peterbalch/Quadruped2/Instructables source/IMG_0923.JPG

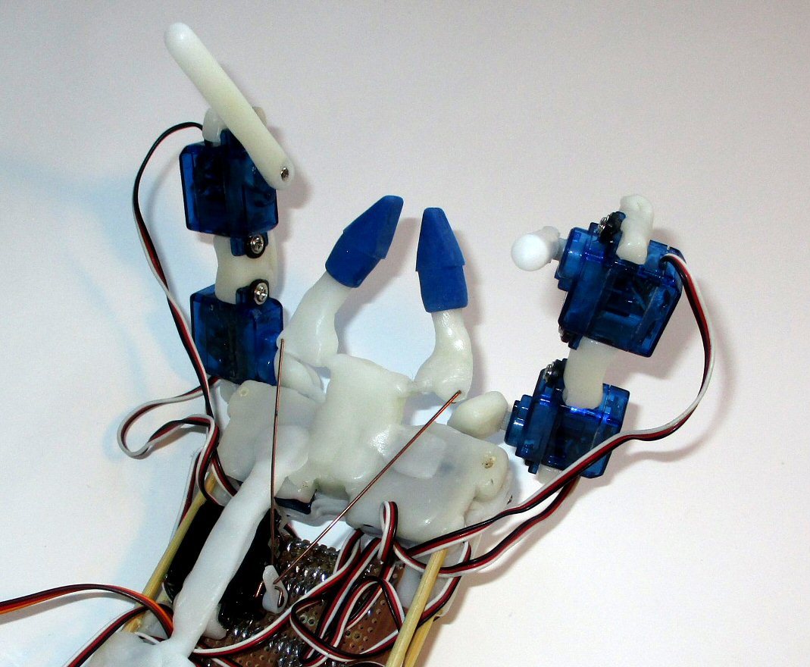
Instructables source/IMG_0923.JPG
