peterbalch/Quadruped2/Instructables source/quadruped.jpg

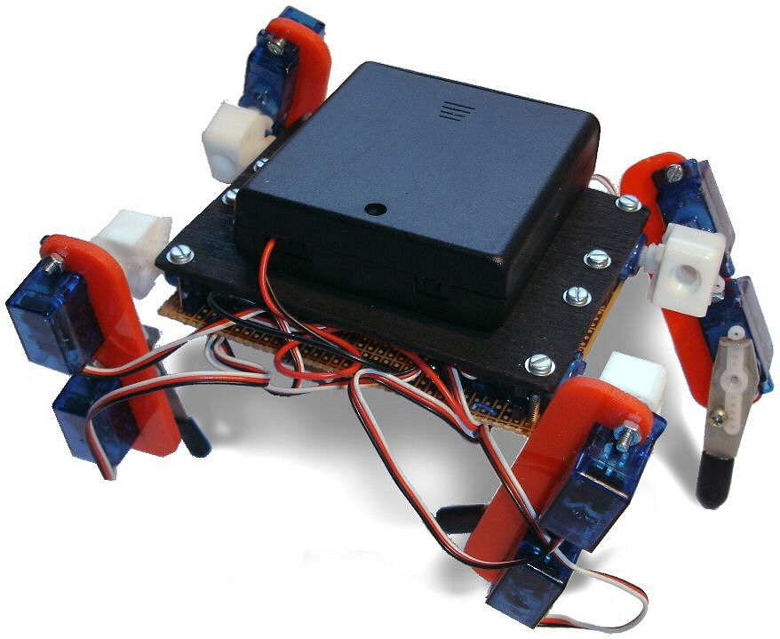
Instructables source/quadruped.jpg
