peterbalch/Quadruped2/Prog/Servo18.rtf

The Arduino Quad3.ino sketch can control up to 18 servos.
• Servo 0 = pin D2
• Servo 1 = pin D3
• Servo 2 = pin D4
• Servo 3 = pin D5
• Servo 4 = pin D6
• Servo 5 = pin D7
• Servo 6 = pin D8
• Servo 7 = pin D9
• Servo 8 = pin D10
• Servo 9 = pin A0
• Servo 10 = pin A1
• Servo 11 = pin A2
• Servo 12 = pin A3
• Servo 13 = pin A4
• Servo 14 = pin A5
• Servo 15 = pin D11
• Servo 16 = pin D12
• Servo 17 = pin D13

The sketch includes my own version of the Servos.h Arduino library but I have added more servos. The standard library allows a maximum of 12 servos per timer and for the Arduino Nano, it uses only one timer. I've modified the Servos.h file to allow 18 servos per timer.

#define SERVOS_PER_TIMER 18 // the maximum number of servos controlled by one timer

And I've renamed it to myServos. Put all the files in the same directory as the Quad3.ino sketch.

Using 18 sevos per timer alters the timing a little when you're using all the servo pins at once but seems to work OK.

Gait-tables can be stored in PROGMEM or EEPROM.

To use EEPROM, include this line in the sketch
• #define UseEEPROM
(It's commented out by default.)

I don't recommend using EEPROM. It's too small to be useful. If a gait typically has 12 poses for 12 servos, that's 144 bytes, So you'll only have room for 7 gaits in the 1024 bytes of EEPROM.

I'm going to assume you're using PROGMEM which is much bigger. In theory you'll have room for hundreds of gait.

Each gait-table has the following format:

• number of poses in gait (1 byte)
• ServoSet - 1 bit per servo (4 bytes)
• servo angles (numposes * servoset.count bytes)

The last gait is followed by a zero byte to mark the end of the tables
• 0 (1 byte)

The Servo18.exe program can write its gait-tables to a file usually called Gaits.h.

A typical Gaits.h file contains
• const byte WaveLegs[] PROGMEM = {
• 9, // num poses
• 0xFB,0x1F,0x00,0x00, // servo set
• 71, 149, 90, 90, 90, 90, 36, 109, 86, 134, 75, 54,
• 71, 149, 90, 90, 90, 90, 36, 109, 86, 134, 134, 120,
• 71, 149, 90, 90, 90, 90, 36, 109, 86, 134, 75, 54,
• 71, 149, 90, 90, 90, 90, 36, 109, 136, 53, 75, 54,
• 71, 149, 90, 90, 90, 90, 36, 109, 86, 134, 75, 54,
• 133, 88, 90, 90, 90, 90, 36, 109, 86, 134, 75, 54,
• 71, 149, 90, 90, 90, 90, 36, 109, 86, 134, 75, 54,
• 71, 149, 90, 90, 90, 90, 84, 41, 86, 134, 75, 54,
• 71, 149, 90, 90, 90, 90, 36, 109, 86, 134, 75, 54};
•
• const byte Grip[] PROGMEM = {
• 2, // num poses
• 0x04,0x00,0x00,0x00, // servo set
• 79,
• 136};

This example contains two gaits: WaveLegs and Grip. With WaveLegs, the robot lies on its back waving its legs in the air (a useful test!). With Grip, the robot opens and closes its gripper.

The WaveLegs table says that is contains 9 poses. The servos it uses are in the set 0x1FFB. That's a long integer with 1 bit per servo There are 12 bits set so the gait uses 12 servos. Bit 2 is set to zero so servo 2 is not used. Then come 9 poses and each pose specifies the angles of 12 servos.

The Grip table says that it contains 2 poses - gripper open or closed. The servos it uses are in the set 0x0004. There is one bit set in the servo-set so the gait uses 1 servo. Bit 2 is set so servo 2 is used for the gripper.

Of course, you will have plugged the leg and gripper servos into different pins. You will have specifed that in the Servo18.exe program.

Opening and closing the gripper is not really a "gait" but it's controlled by a gait-table so we'll call it a gait.

The Arduino Quad3.ino sketch can accept the following command bytes over the USB cable from the PC:

• 181..199: select the current servo as N-181
• 0..180: select the current servo angle to N
• 200: send EEPROM contents from PC to Arduino
• followed by 1024 bytes of data
• Arduino replies to each byte with 0xFF
• 201: fetch EEPROM contents from Arduino to PC
• Arduino replies with 1024 bytes of data followed by 0xFF
• 202: starts running a gait in the Arduino
• followed by 1 byte of gait number
• Arduino replies with 0xFF
• 203: set MaxSpeed
• followed by 1 byte of gait number
• followed by 1 byte of speed
• Arduino replies with 0xFF
• 204: set MinTime
• followed by 1 byte of gait number
• followed by 1 byte of min approach time
• Arduino replies with 0xFF
• 205: BlendRun:
• followed by 1 byte of gait table A
• followed by 1 byte of share of A
• followed by 1 byte of gait table B
• followed by 1 byte of share of B
• followed by 1 byte of start pose; may be 255
• followed by 1 byte of end pose; may be 255
• Arduino replies with 0xFF
• 206: StopNow:
• followed by 1 byte of gait number
• Arduino replies with 0xFF
• 207: StopWhen:
• followed by 1 byte of gait number
• followed by 1 byte of pose number
• Arduino replies with 0xFF
• 208: QueryPose
• followed by 1 byte of gait number
• Arduino replies with the current pose of the gait (or 255 if gait not running)
• 209: AtTargets
• followed by 1 byte of gait number
• Arduino replies with 1 if serovs positions same as target positions; 0 they are not or 255 if gait not running

Commands 200 and 201 can only be used if you've enabled storing gaits in EEPROM.

You can run a gait from your program by calling
• RunTable(WaveLegs, 0, 255);

start running a gait <<<<<<<<<<<<<<
void RunTable(int gait_table_addr, byte poseN, byte poseM)
run once from pose N to pose M
if N = 255 then start wherever you currently are
if M = 255 then run forever
loop back to beginning

each gait has its own max speed
each gait has its own min time

The function of the Quad3.ino sketch is to accept and run commands from a PC and allow you to develop your gait-tables. You will replace it with your own sketch that does something useful with your robot.

Notice how the main loop of my program contains the code

RunGaits();

RunGaits() runs the code to control running the gait tables. If you don't call it every few milliseconds, none of the gaits will run. So you must remember to call it inside any loops that are waiting for something to happen.
