peterbalch/Quadruped2/Prog/ARDUINO.BMP

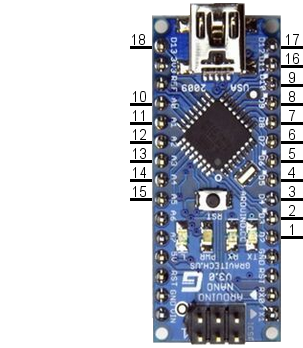
Prog/ARDUINO.BMP
