peterbalch/Quadruped2/Prog/Arm.bmp

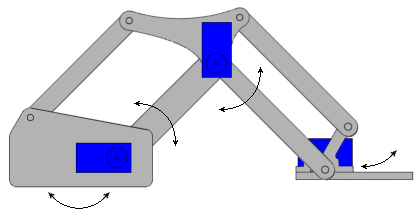
Prog/Arm.bmp
