peterbalch/Quadruped2/Prog/WALK2.BMP

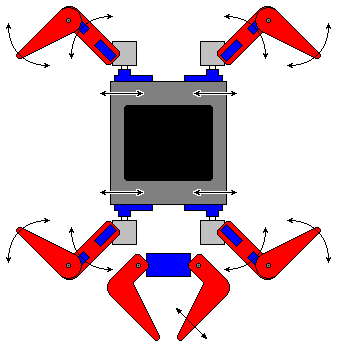
Prog/WALK2.BMP
