peterbalch/Quadruped2/Instructables source/grip.png

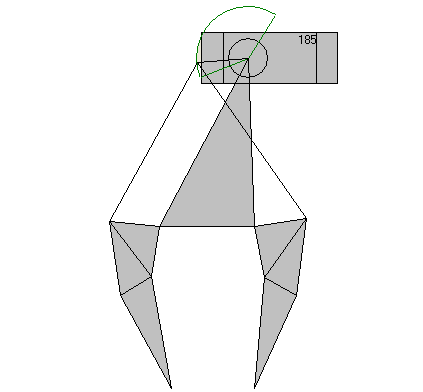
Instructables source/grip.png
