peterbalch/Quadruped2/Instructables source/Image2.jpg

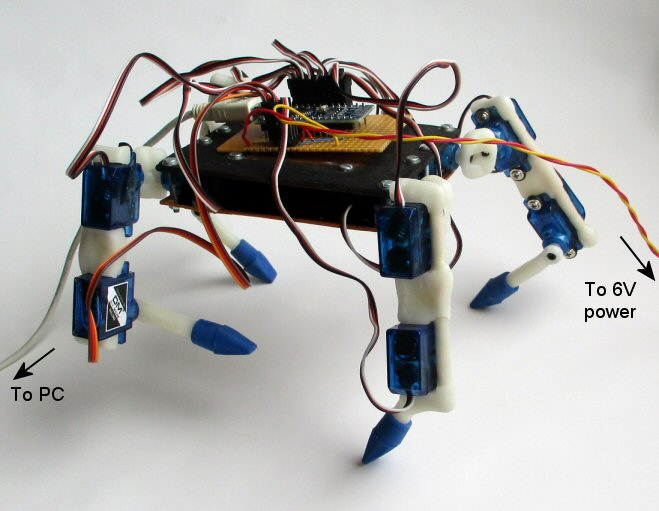
Instructables source/Image2.jpg
