peterbalch/Quadruped2/Instructables source/Image2a.png

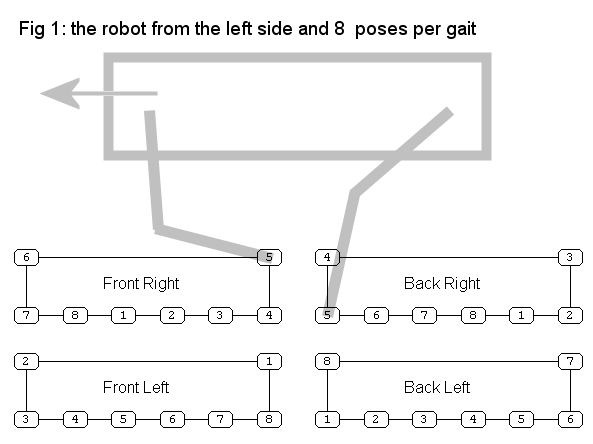
Instructables source/Image2a.png
