peterbalch/Quadruped2/Instructables source/Image2b.png

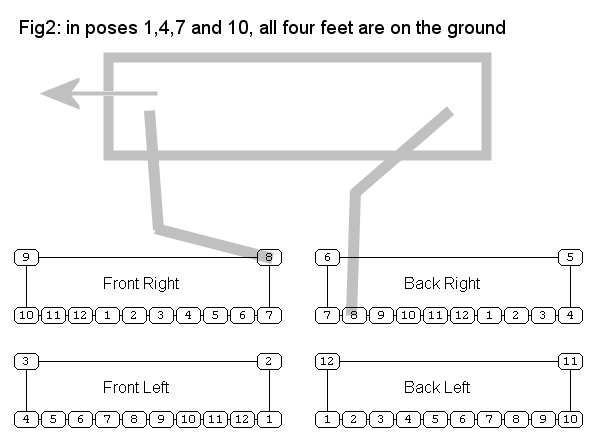
Instructables source/Image2b.png
