peterbalch/Quadruped2/Instructables source/Image3.png

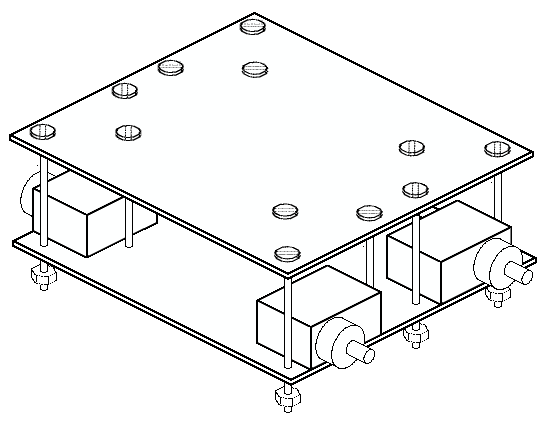
Instructables source/Image3.png
