peterbalch/Quadruped2/Instructables source/Image4.png

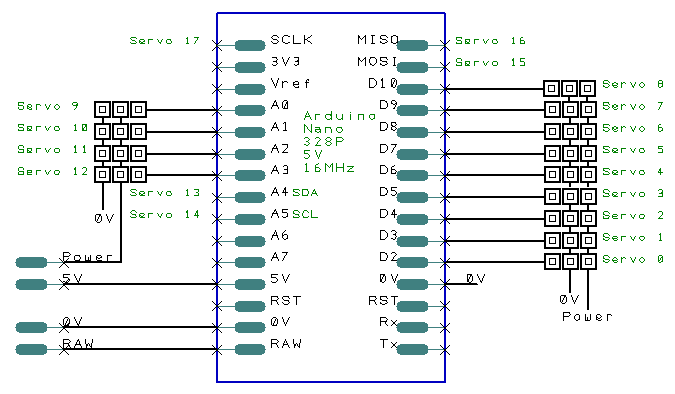
Instructables source/Image4.png
