peterbalch/Quadruped2/Instructables source/Image5.png

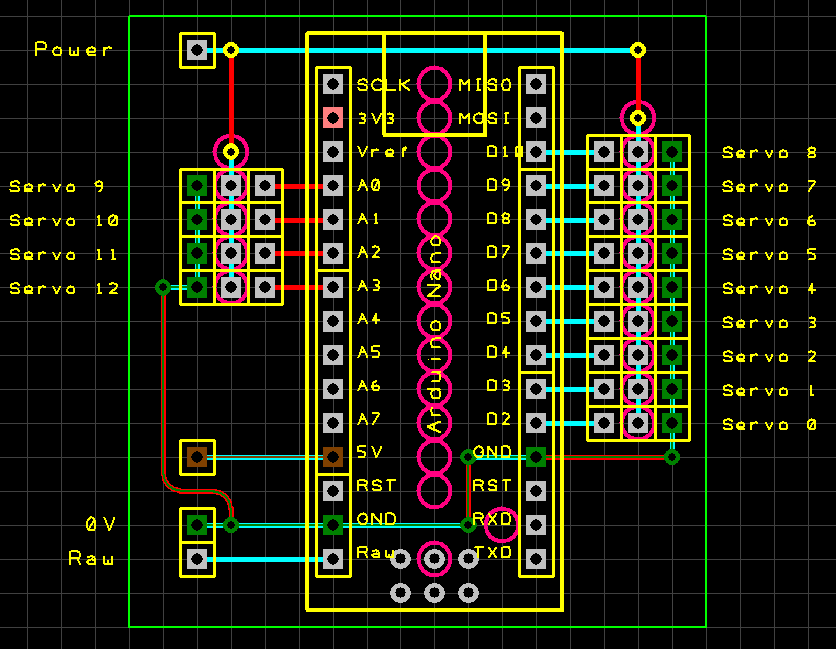
Instructables source/Image5.png
