peterbalch/Quadruped2/Instructables source/Image6.png

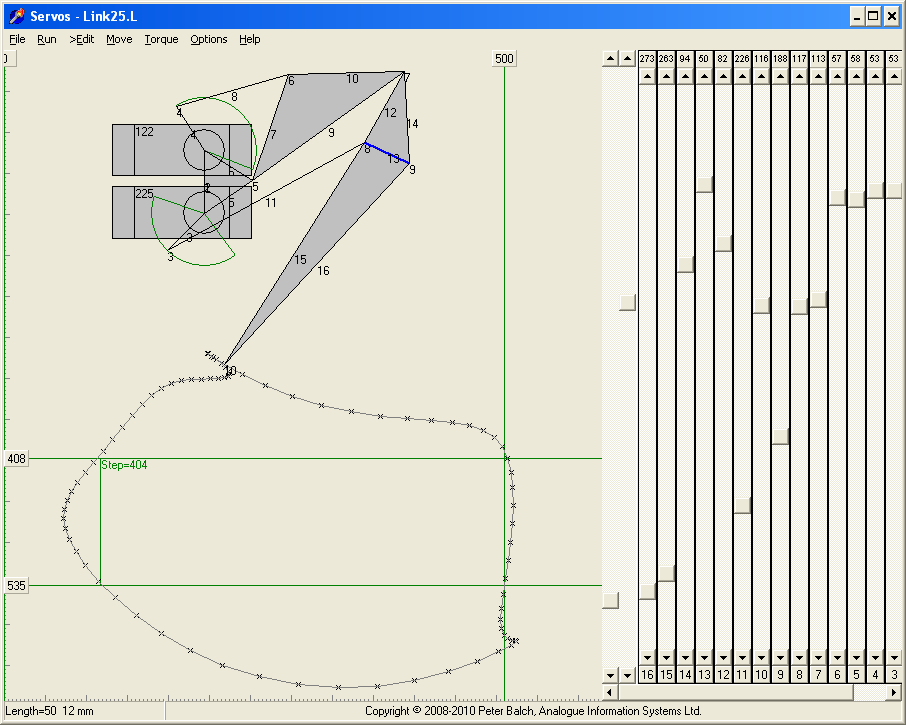
Instructables source/Image6.png
