peterbalch/Quadruped2/Instructables source/Image7.png

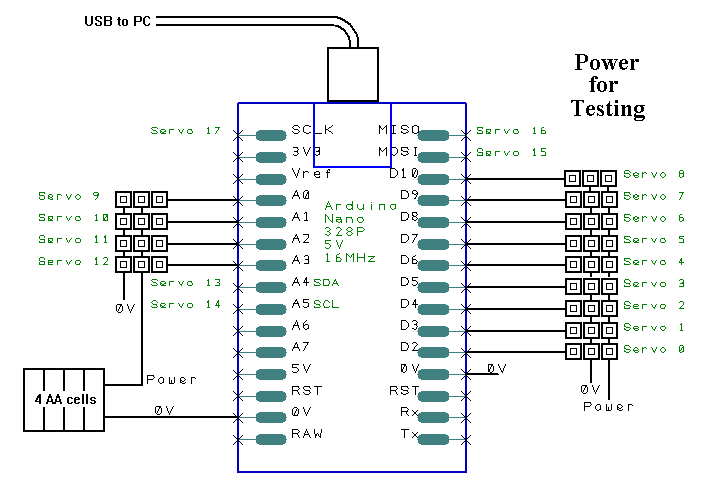
Instructables source/Image7.png
