peterbalch/Quadruped2/Instructables source/Image8.png

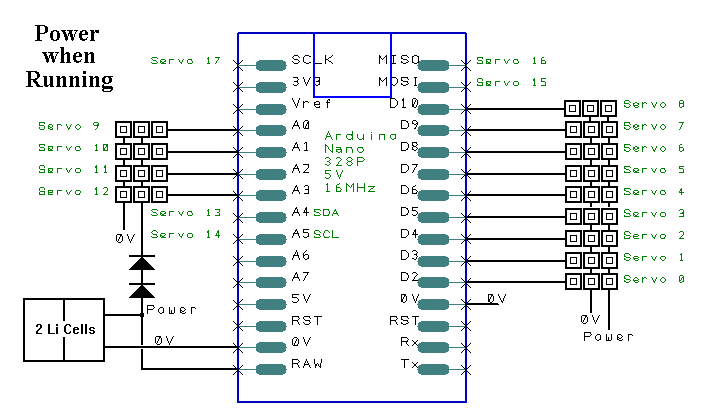
Instructables source/Image8.png
