peterbalch/Quadruped2/Instructables source/Image9.png

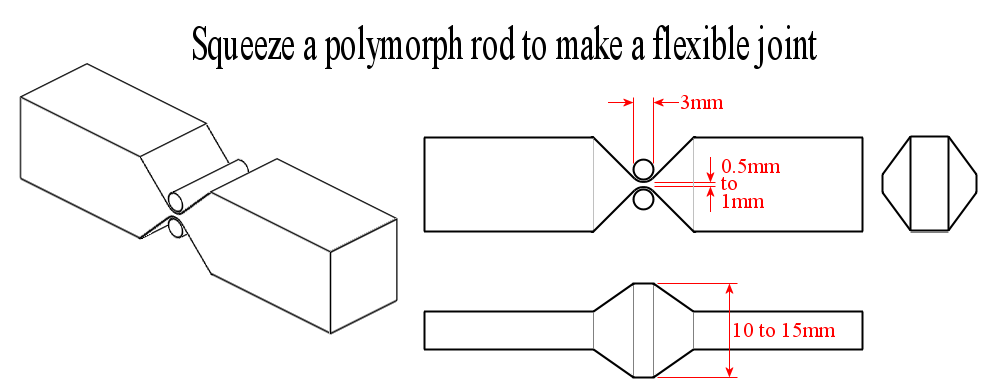
Instructables source/Image9.png
