peterbalch/Quadruped2/Instructables source/Image10.png

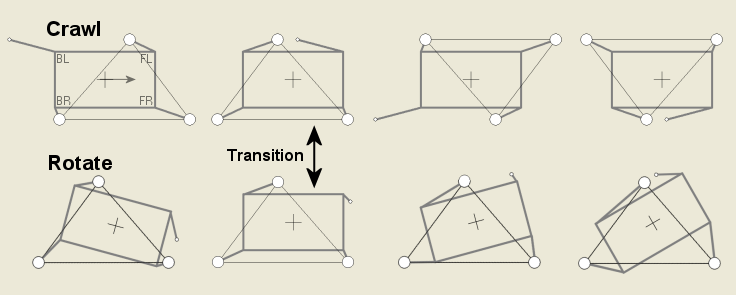
Instructables source/Image10.png
