peterbalch/Quadruped2/Instructables source/Image13.png

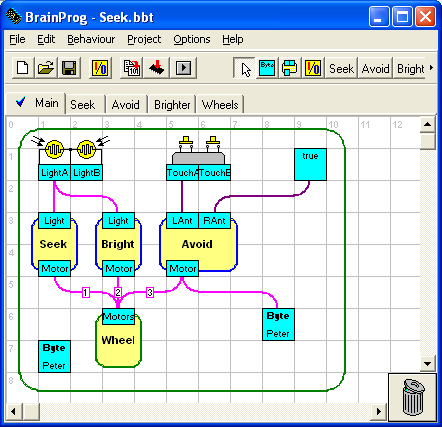
Instructables source/Image13.png
