peterbalch/Quadruped2/Instructables source/Image15.png

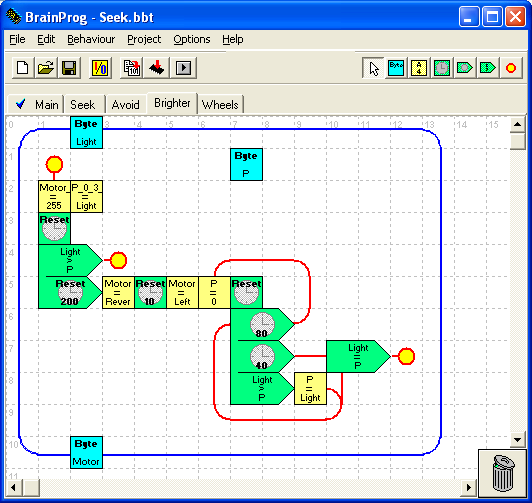
Instructables source/Image15.png
