peterbalch/Quadruped2/Instructables source/Image17.png

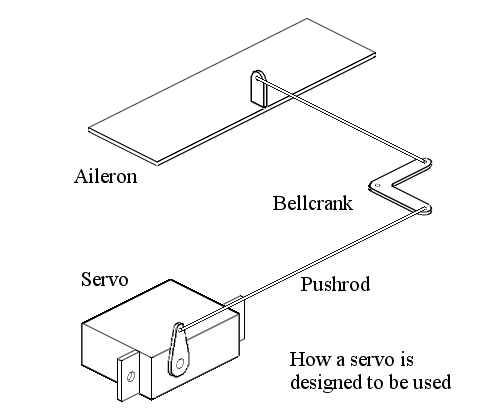
Instructables source/Image17.png
