peterbalch/Quadruped2/Instructables source/Image19.png

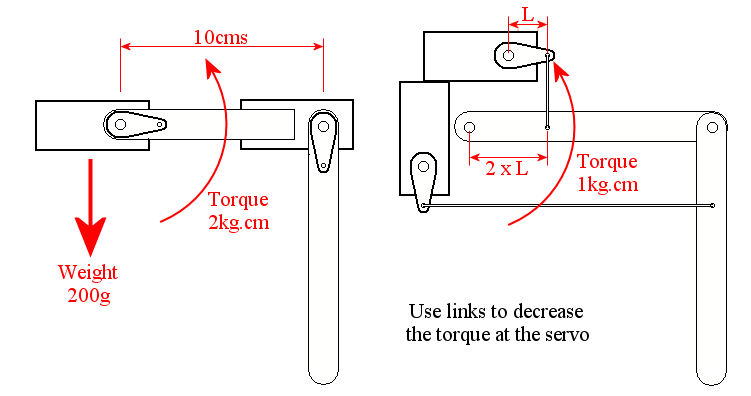
Instructables source/Image19.png
