peterbalch/Quadruped2/Instructables source/Image22.png

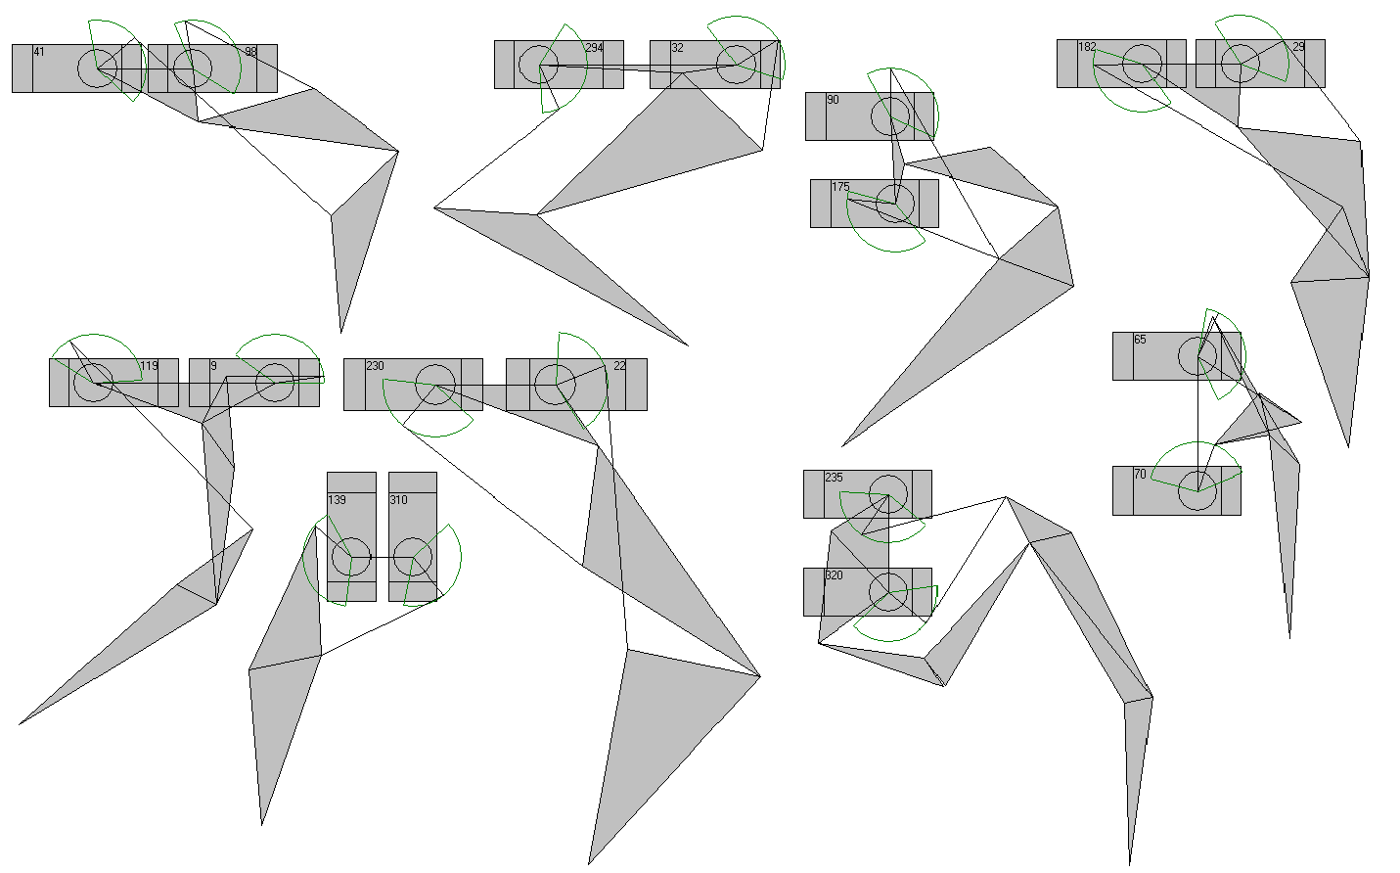
Instructables source/Image22.png
