peterbalch/Quadruped2/Instructables source/Image39.png

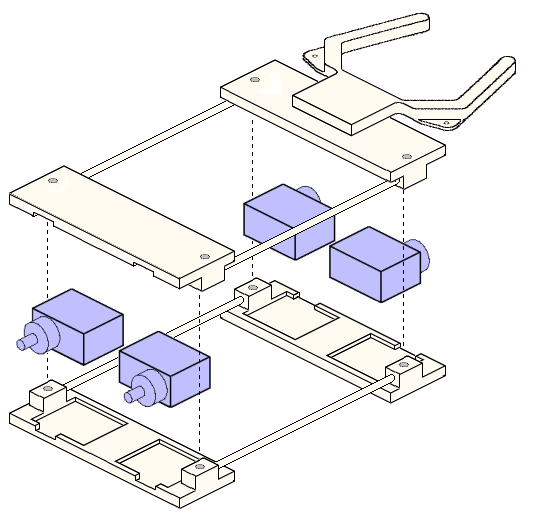
Instructables source/Image39.png
