peterbalch/Quadruped2/Instructables source/Image44.png

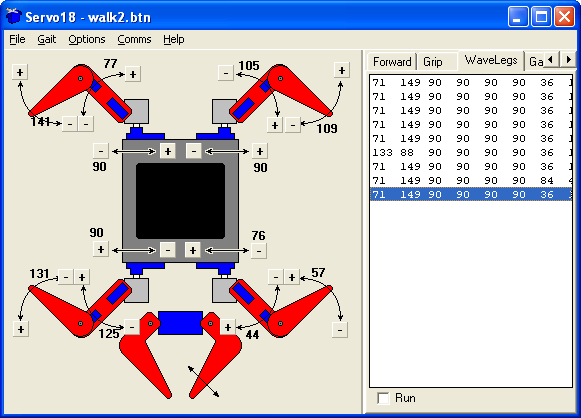
Instructables source/Image44.png
