peterbalch/Quadruped2/Instructables source/Image110.png

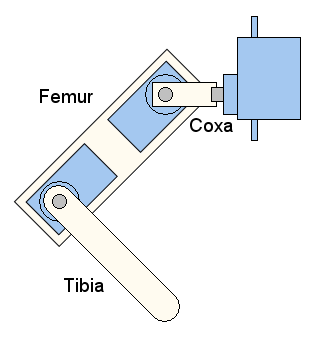
Instructables source/Image110.png
