peterbalch/Quadruped2/Instructables source/img600.jpg

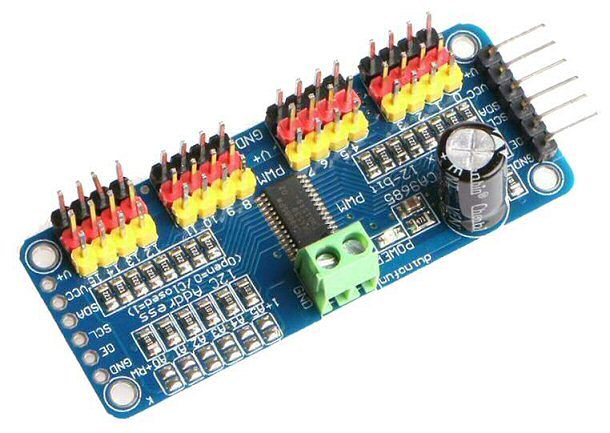
Instructables source/img600.jpg
