peterbalch/Quadruped2/Instructables source/IMG_0687.JPG

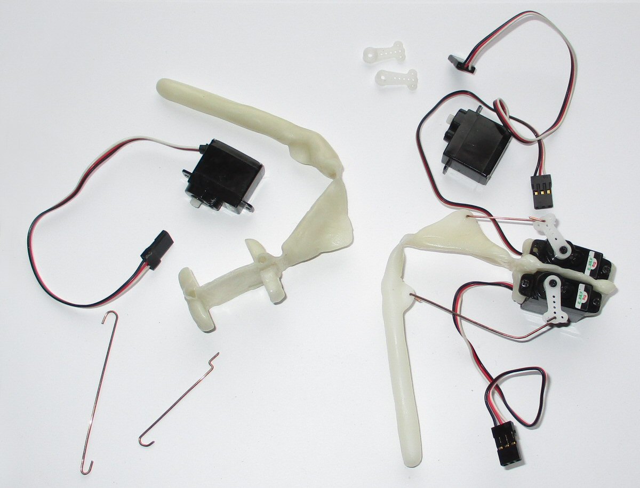
Instructables source/IMG_0687.JPG
