peterbalch/Quadruped2/Instructables source/IMG_0712.JPG

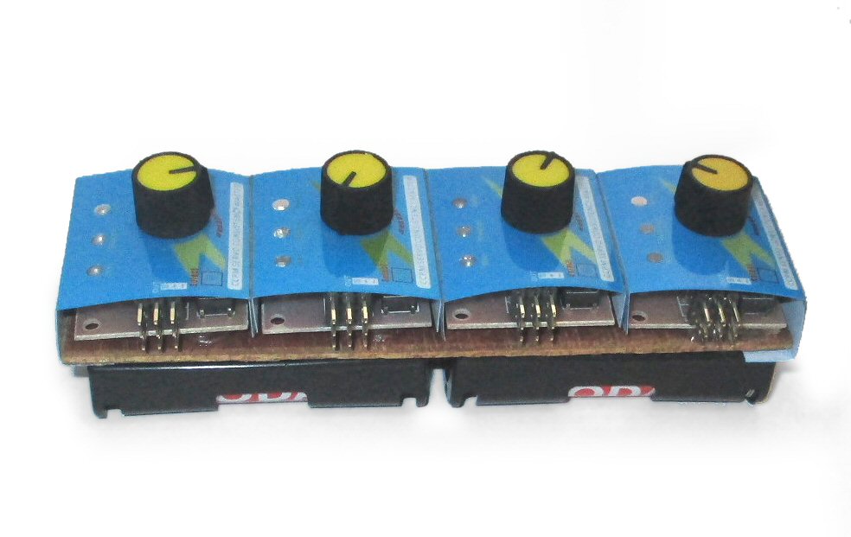
Instructables source/IMG_0712.JPG
