peterbalch/Quadruped2/Instructables source/IMG_0722.JPG

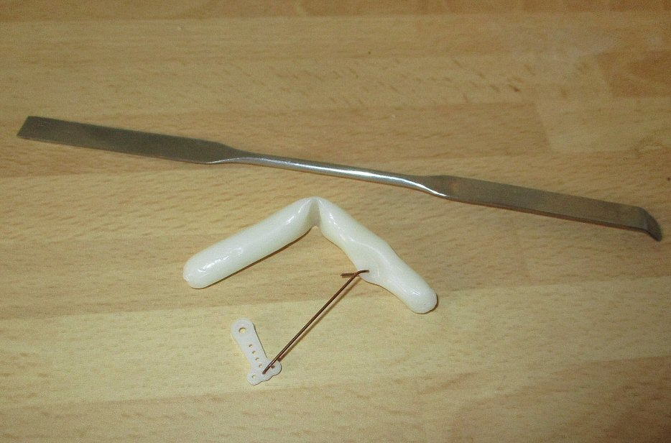
Instructables source/IMG_0722.JPG
