peterbalch/Quadruped2/Instructables source/IMG_0762.JPG

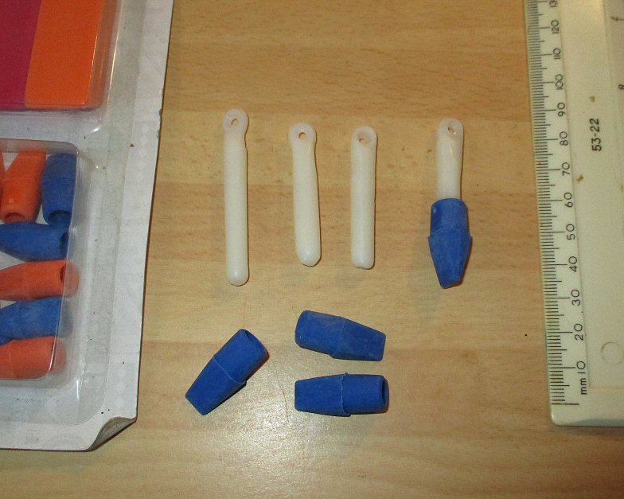
Instructables source/IMG_0762.JPG
