peterbalch/Quadruped2/Instructables source/IMG_0771.JPG

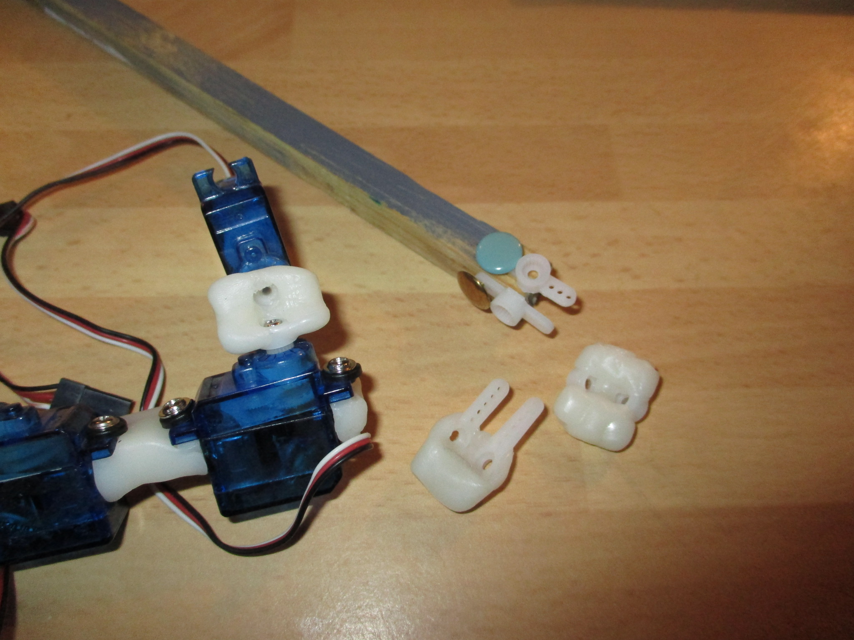
Instructables source/IMG_0771.JPG
