peterbalch/Quadruped2/Instructables source/IMG_0779.JPG

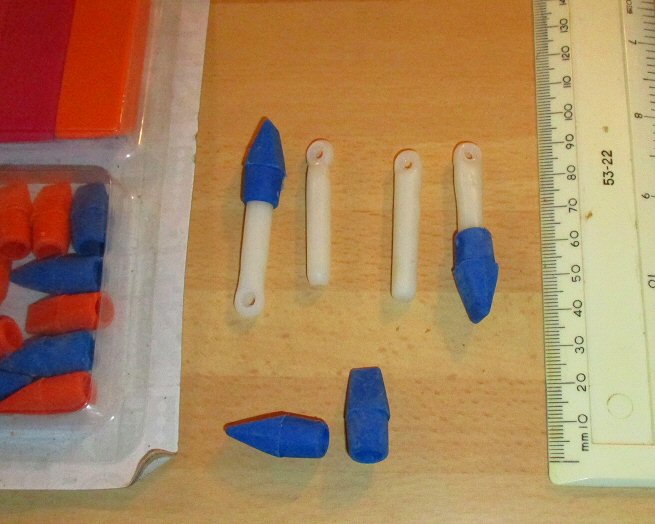
Instructables source/IMG_0779.JPG
