peterbalch/Quadruped2/Instructables source/IMG_0811.JPG

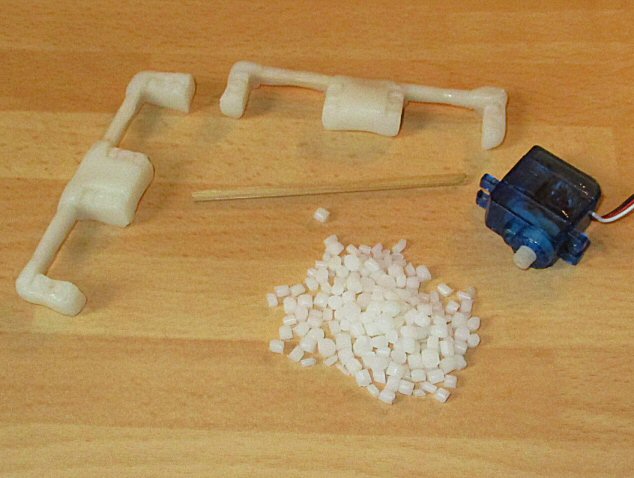
Instructables source/IMG_0811.JPG
