peterbalch/Quadruped2/Instructables source/IMG_0848.JPG

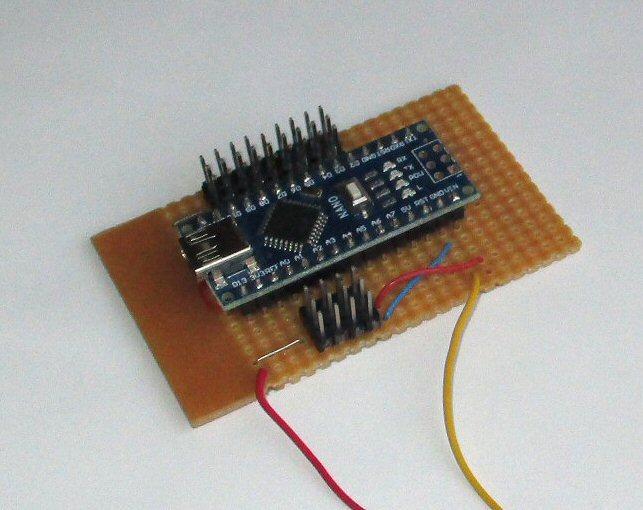
Instructables source/IMG_0848.JPG
