peterbalch/Quadruped2/Instructables source/IMG_0859.JPG

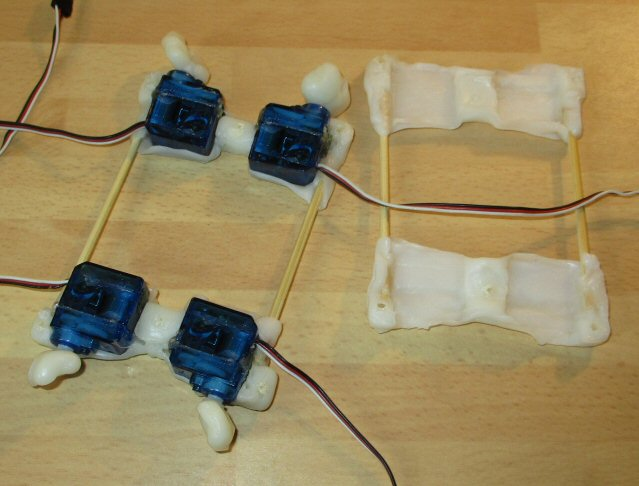
Instructables source/IMG_0859.JPG
