peterbalch/Quadruped2/Instructables source/IMG_0874.JPG

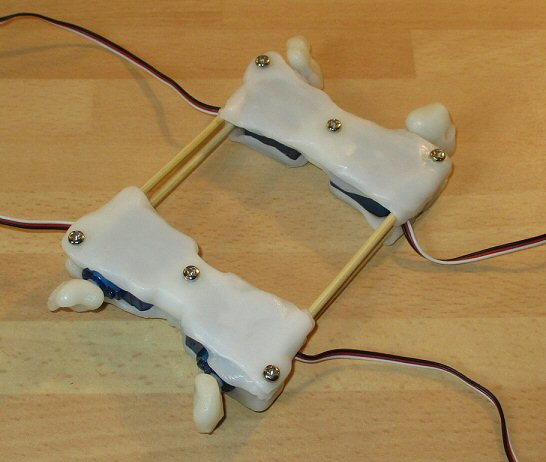
Instructables source/IMG_0874.JPG
