peterbalch/Quadruped2/Instructables source/IMG_0876.JPG

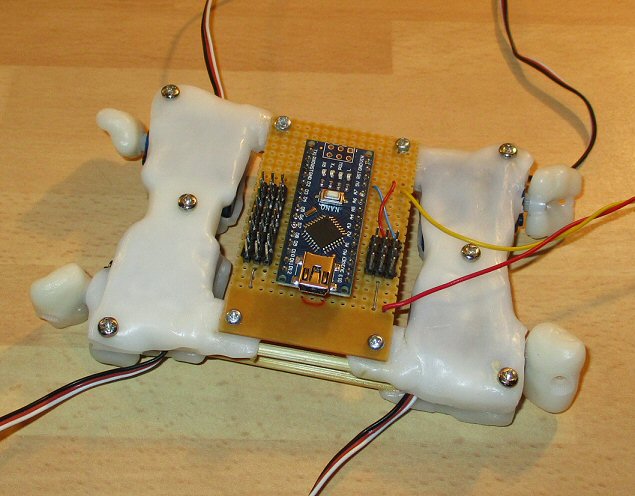
Instructables source/IMG_0876.JPG
