peterbalch/Quadruped2/Instructables source/IMG_0915.JPG

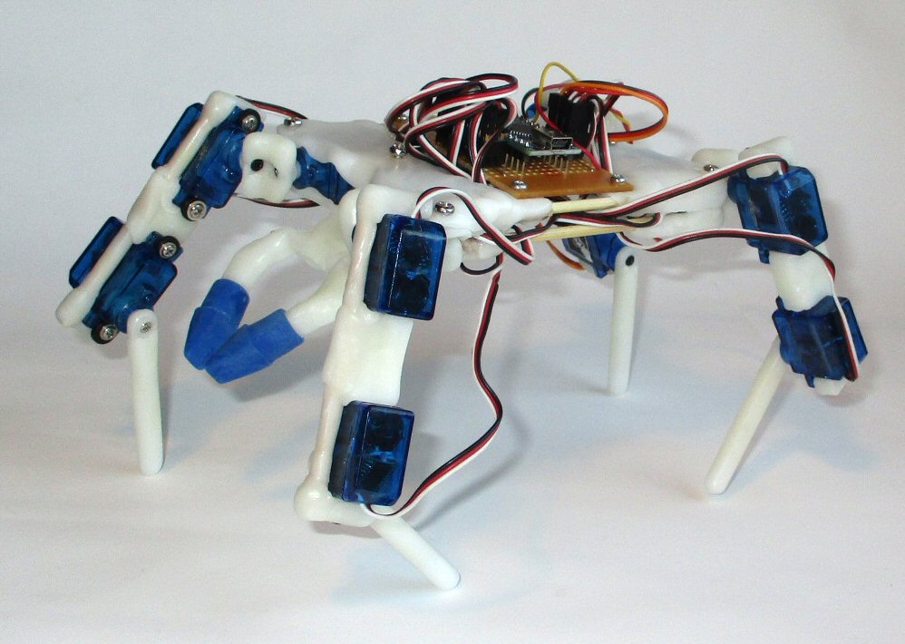
Instructables source/IMG_0915.JPG
