peterbalch/Quadruped2/Instructables source/IMG_0933a.JPG

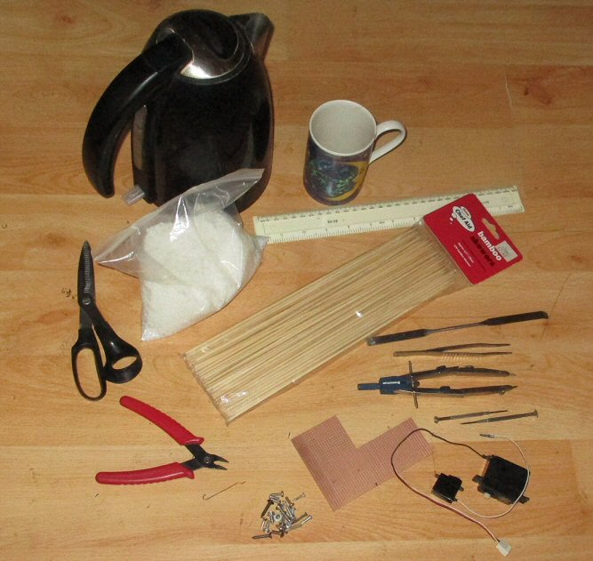
Instructables source/IMG_0933a.JPG
