peterbalch/Quadruped2/Instructables source/Picture 065.jpg

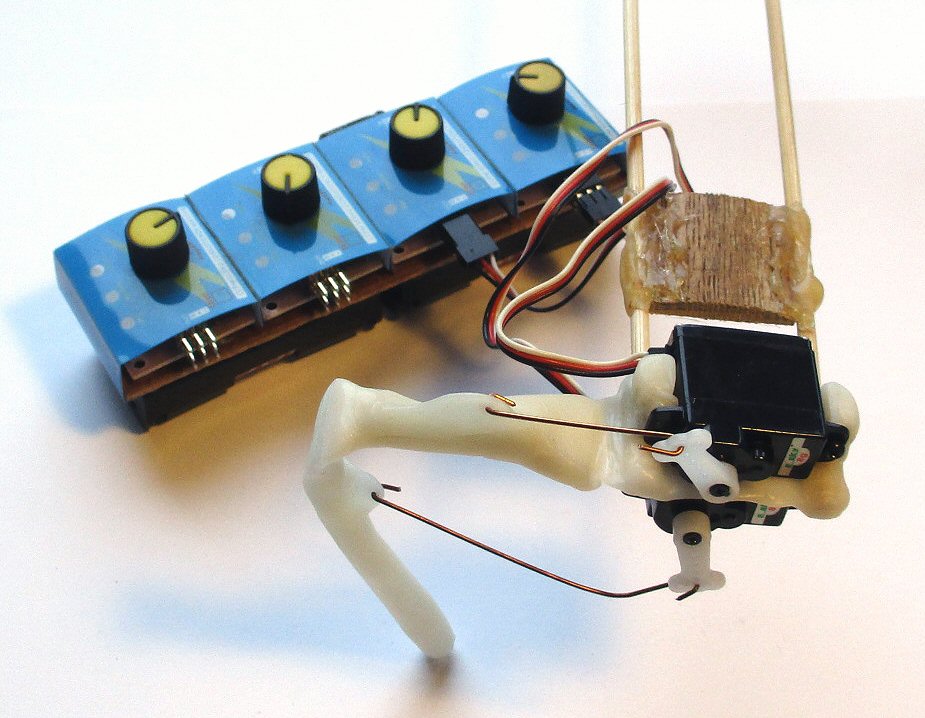
Instructables source/Picture 065.jpg
