peterbalch/Quadruped2/Instructables source/quad2a.PNG

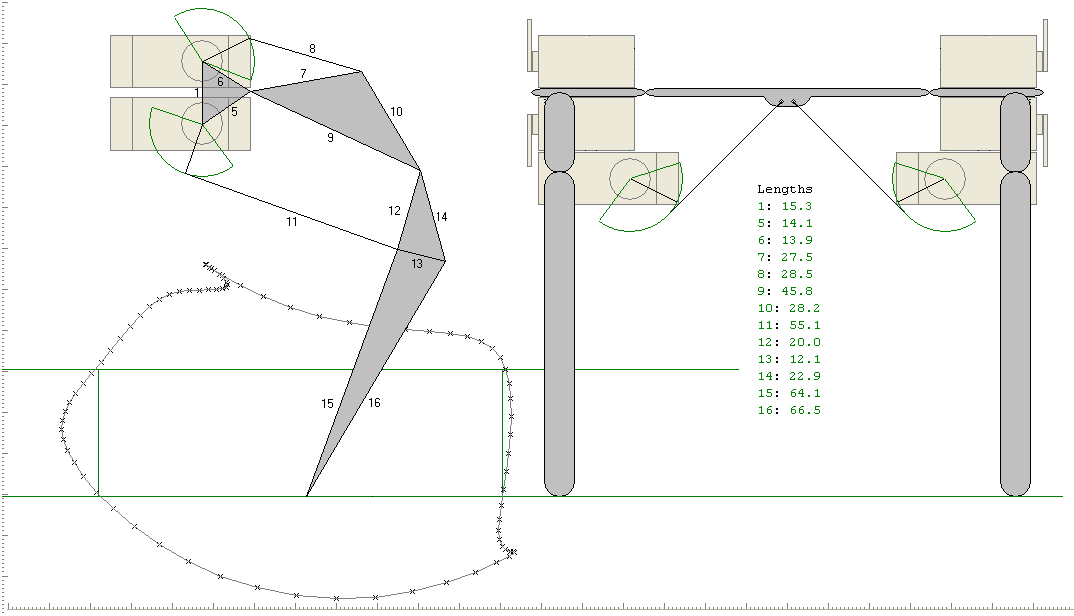
Instructables source/quad2a.PNG
