peterbalch/Quadruped2/Instructables source/Servo.gif

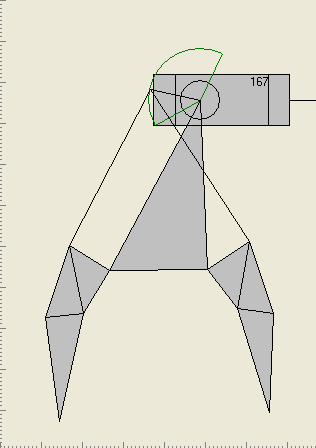
Instructables source/Servo.gif
