peterbalch/Quadruped2/Instructables source/ServoLeg.gif

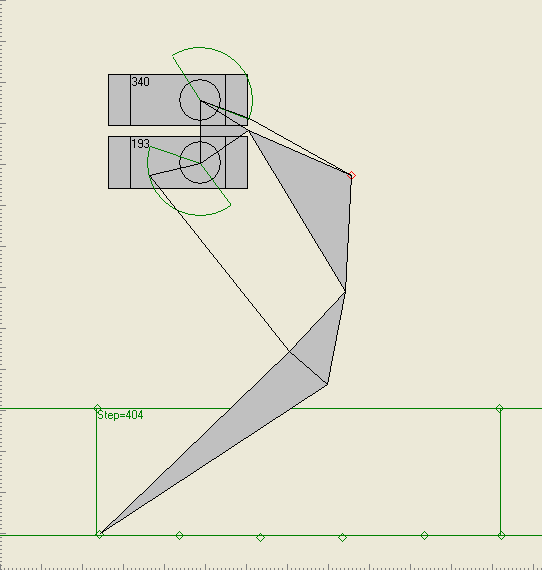
Instructables source/ServoLeg.gif
