peterbalch/Quadruped2/Instructables source/untitled7.PNG

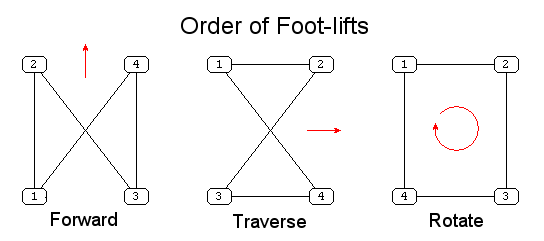
Instructables source/untitled7.PNG
