peterbalch/Quadruped2/Servos/Servos.INI

[Form1]
Left=67
Top=35
Width=906
Height=725
[General]
OpenDialog1.filename="Link25.L"
[Torque]
seScale.Value=41
seWgtFoot.Value=140
seMaxTorque.Value= 5.00000000000000E-0001
cbMaxTorque.Checked=0
